mocchan0221/Denshi_fuka/README.md

# プログラマブルデジタル電子負荷
## What's this?
PCから制御、データの受信などが出来、電流値を好きな関数などで制御できる電子負荷です。

高電圧・小電流回路と低電圧・大電流回路の2つを使い分けることが出来ます。
