mocchan0221/Denshi_fuka/pcb/PDF/Final.pdf

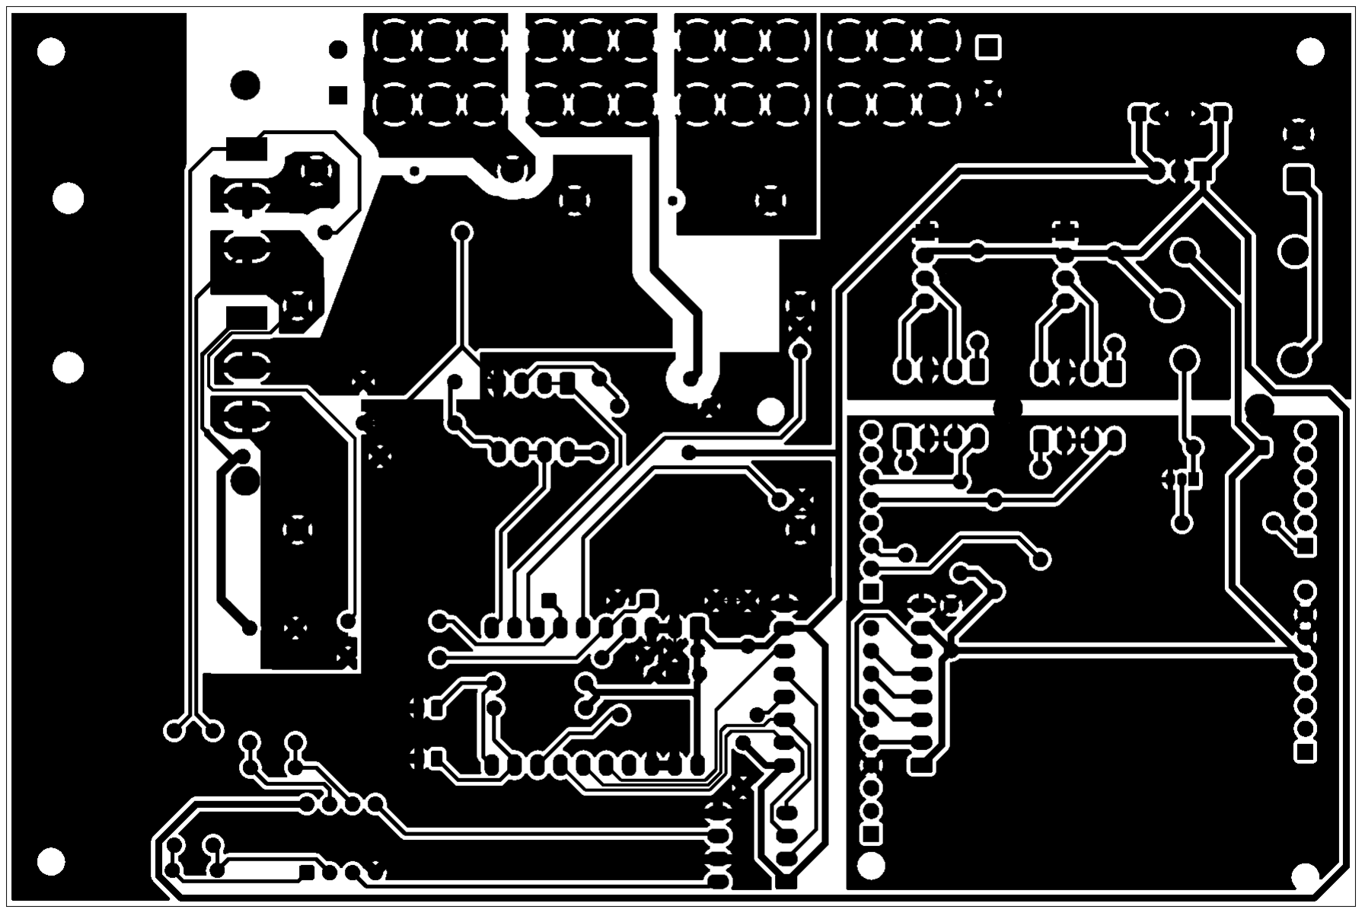
[picture p1: figure]
