mocchan0221/Denshi_fuka/pcb/PDF/アートボード 1.pdf

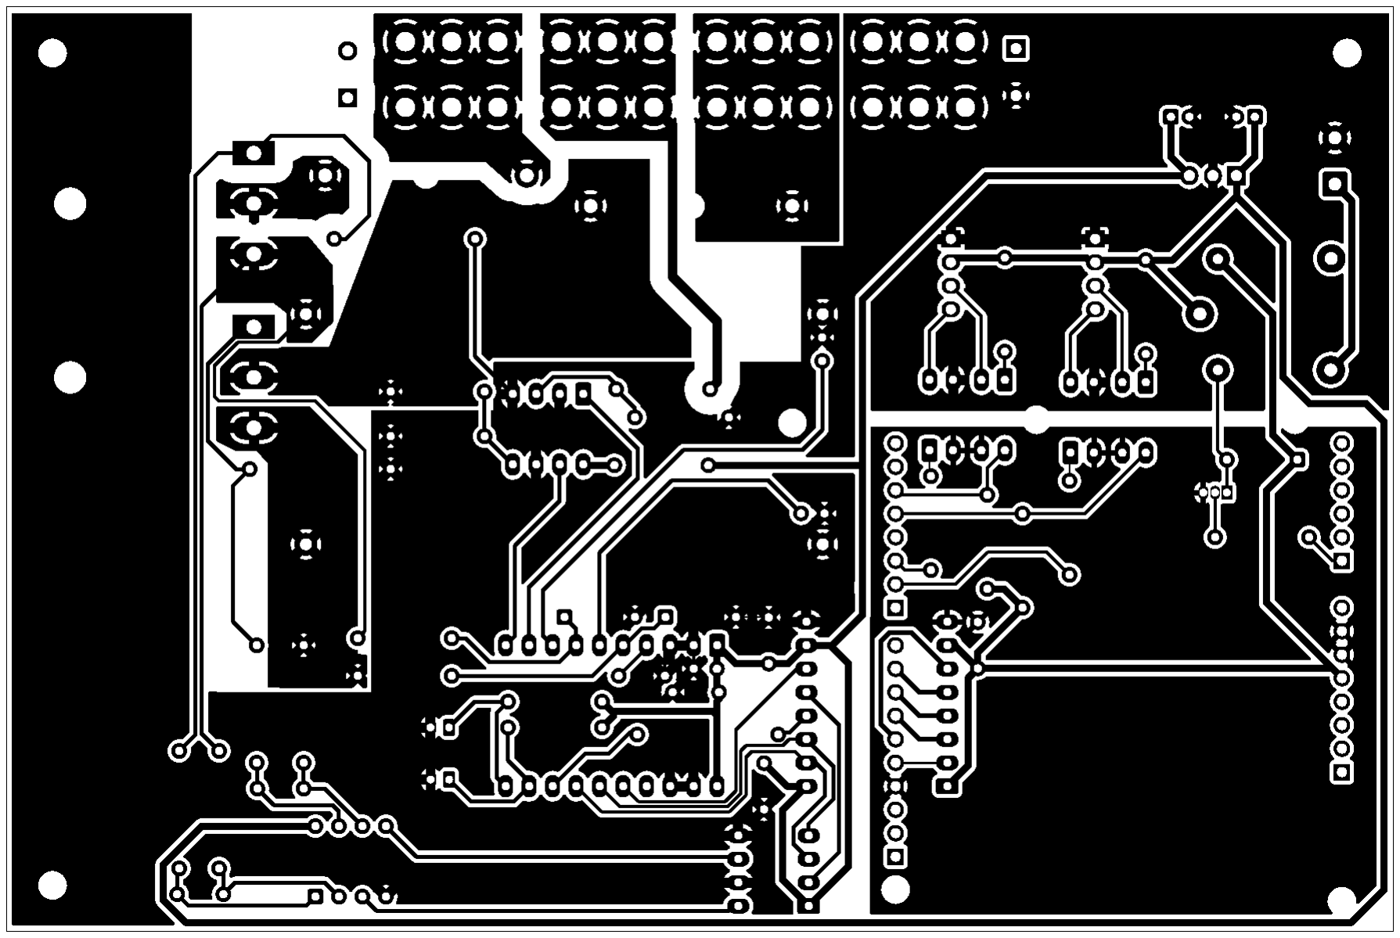
[picture p2: figure]
