mocchan0221/Denshi_fuka/pcb/PDF/エッチング.pdf

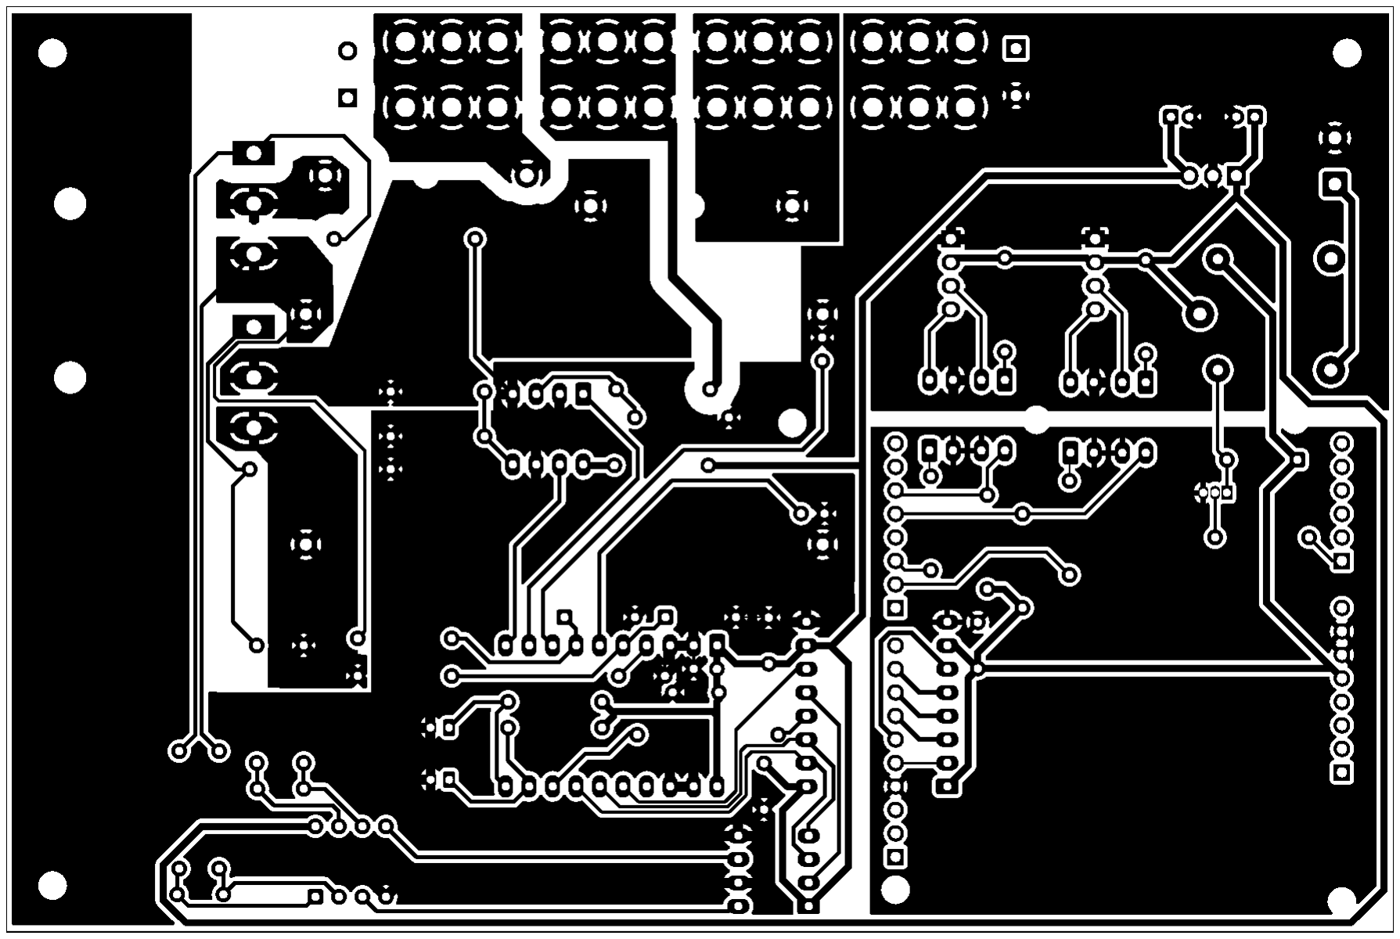
[picture p3: figure]
