mocchan0221/Denshi_fuka/case/電子負荷台座.step

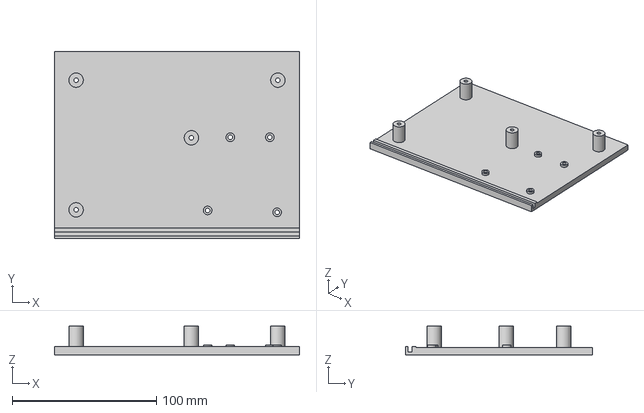
[picture p4: CAD file, 2026-05-17]
case/電子負荷台座.step
170.0 x 130.0 x 20.0 mm
