mocchan0221/Denshi_fuka/pcb/pcb.step

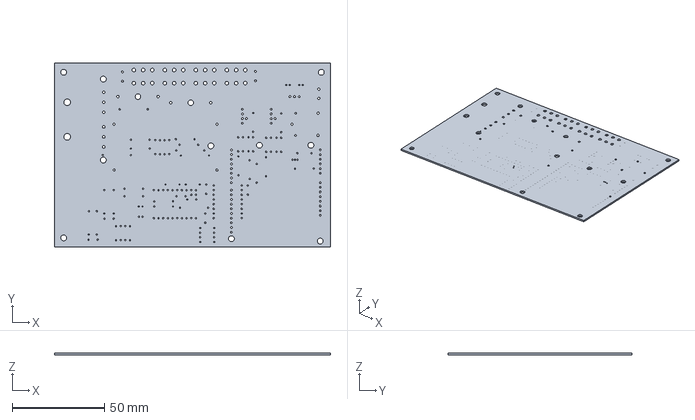
[picture p5: CAD file, 2026-05-10]
pcb/pcb.step
150.0 x 100.0 x 1.00 mm
