mocchan0221/Denshi_fuka/pcb/Denshi_fuka_sch.pdf

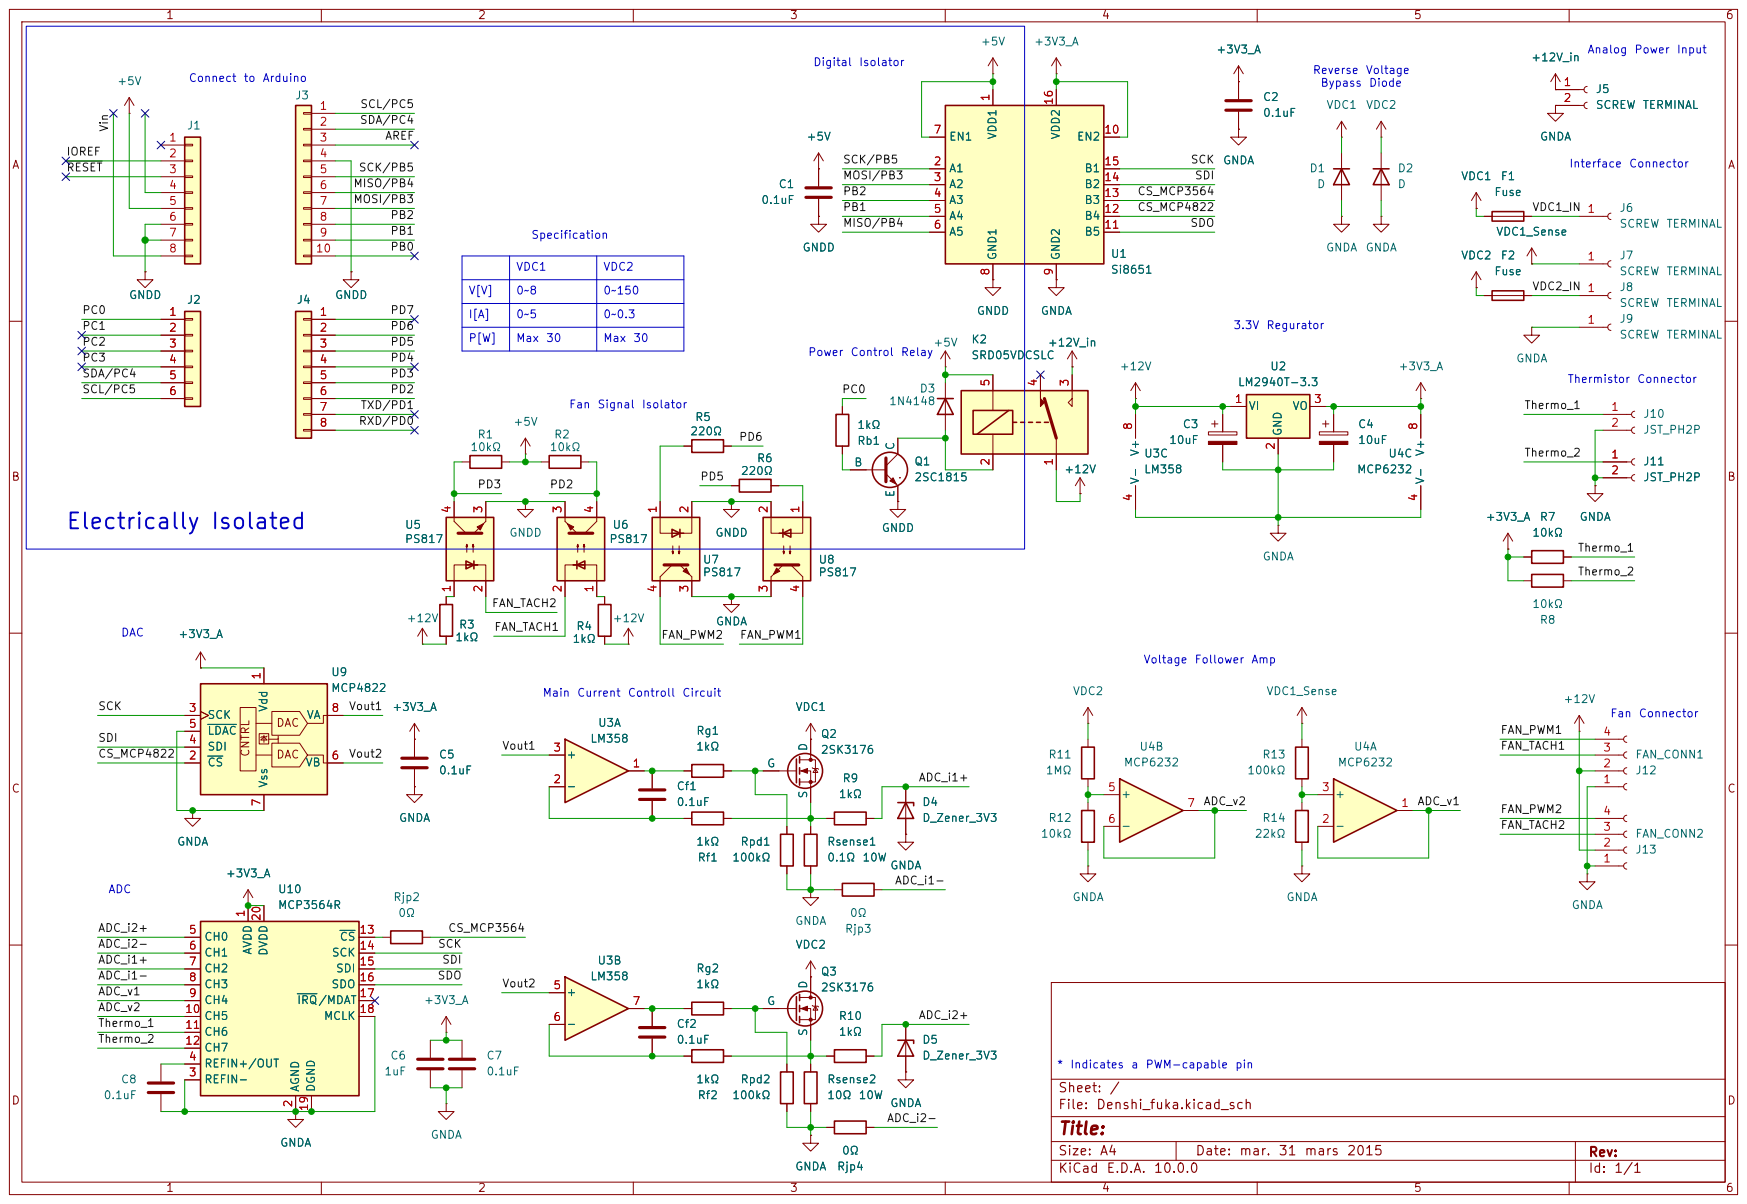
[picture p6: page 1]

Interface Connector Main Current Controll Circuit

A3 4 | CS_MCP3564
A4 5 | CS_MCP4822

Thermistor Connector Fan Connector

2 REFIN- 3 REFIN+/OUT 4 CH0 5 CH1 6 CH2 7 CH3 8 CH4 9 CH5 10 CH6 11 CH7 12 CS 13

* Indicates a PWM-capable pin
Sheet: /
D Date: mar. 31 mars 2015 KiCad E.D.A. 10.0.0
File: Denshi_fuka.kicad_sch
Title:

Size: A4 | Rev:
