mocchan0221/Denshi_fuka/pcb/Denshi_fuka_Assembly.pdf

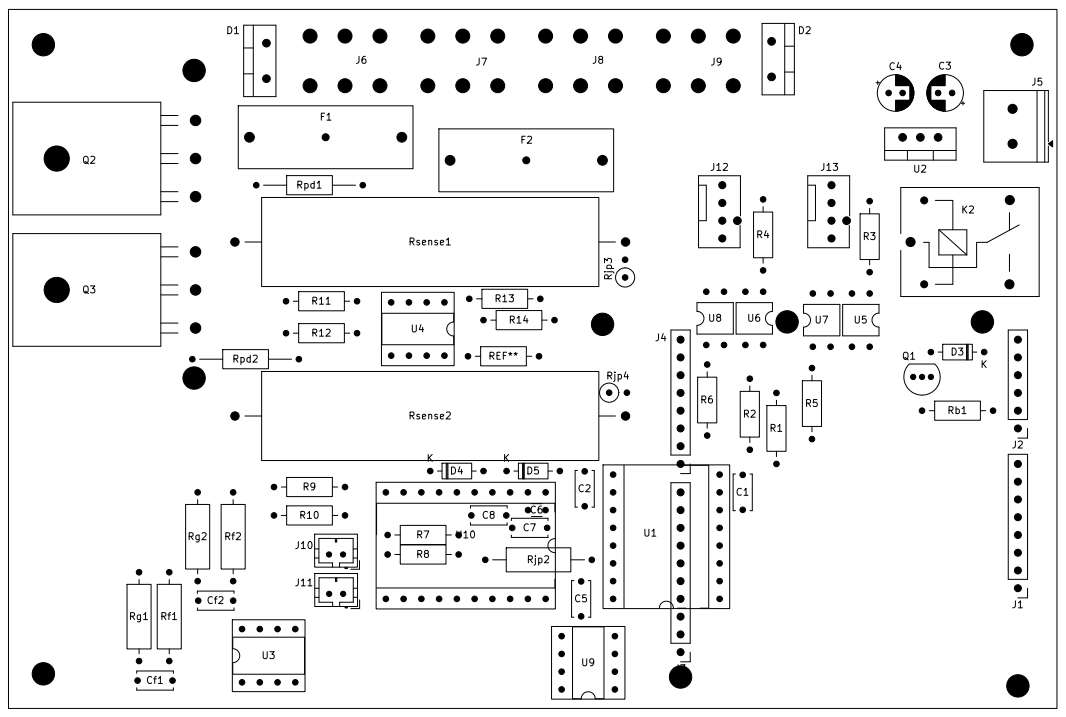
[picture p7: page 1]
