mocchan0221/Denshi_fuka/pcb/Denshi_fuka.pdf

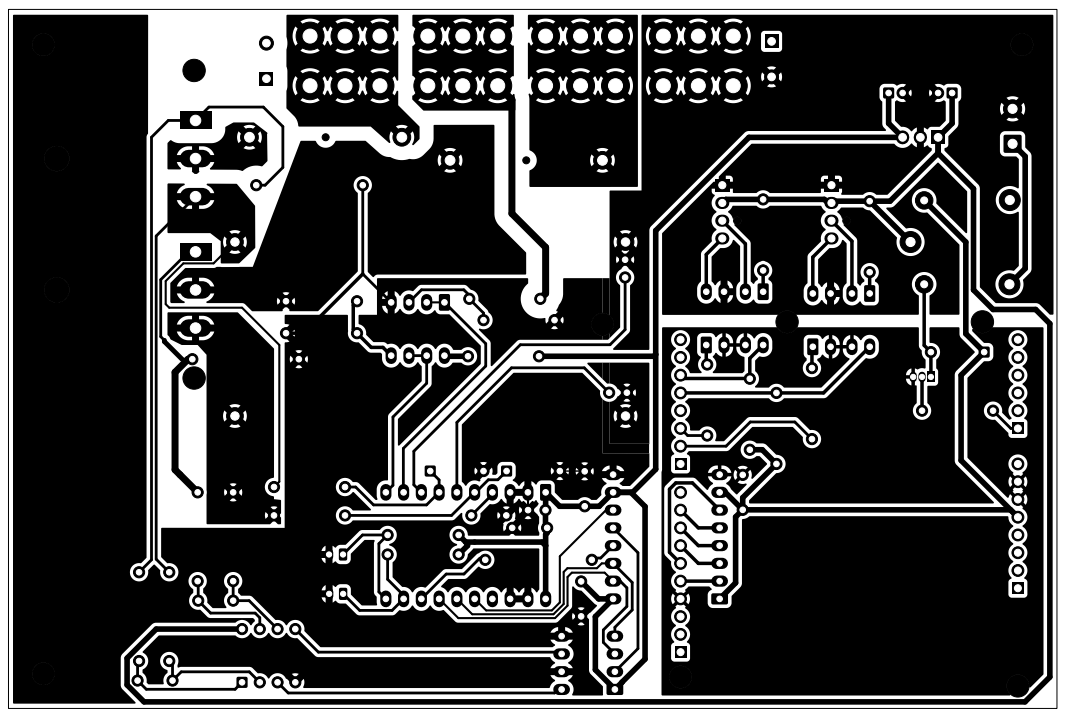
[picture p8: page 1]
