mocchan0221/Denshi_fuka/pcb/Denshi_fuka_Drill.pdf

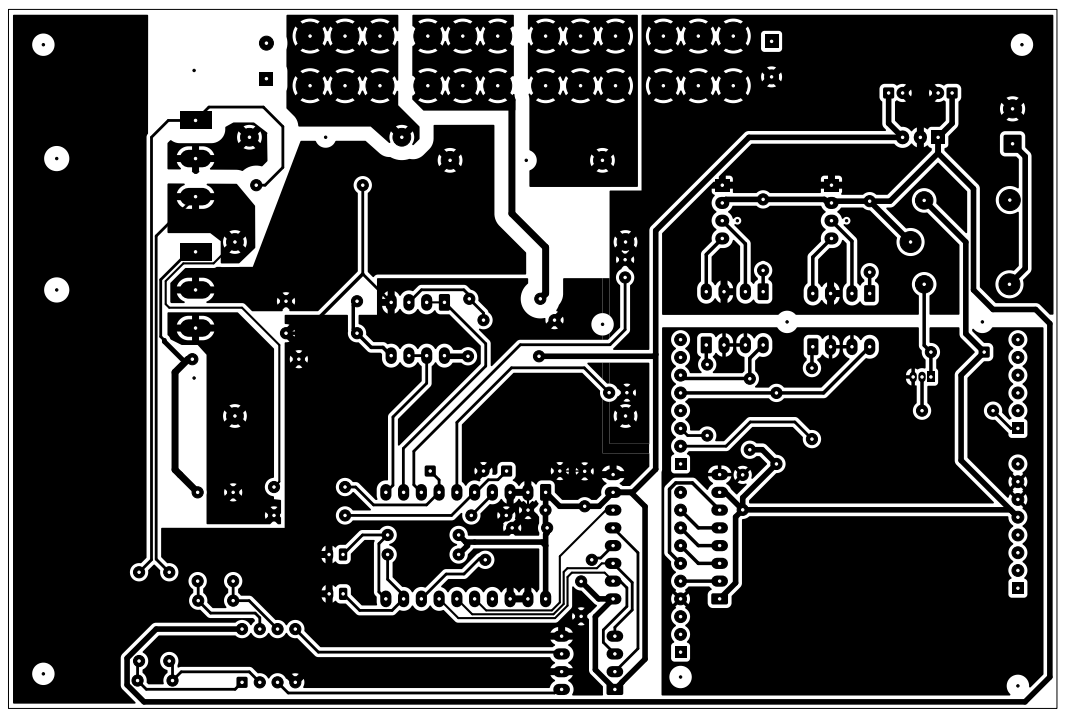
[picture p9: page 1]
