mocchan0221/Denshi_fuka/pcb/PDF/Final2.pdf

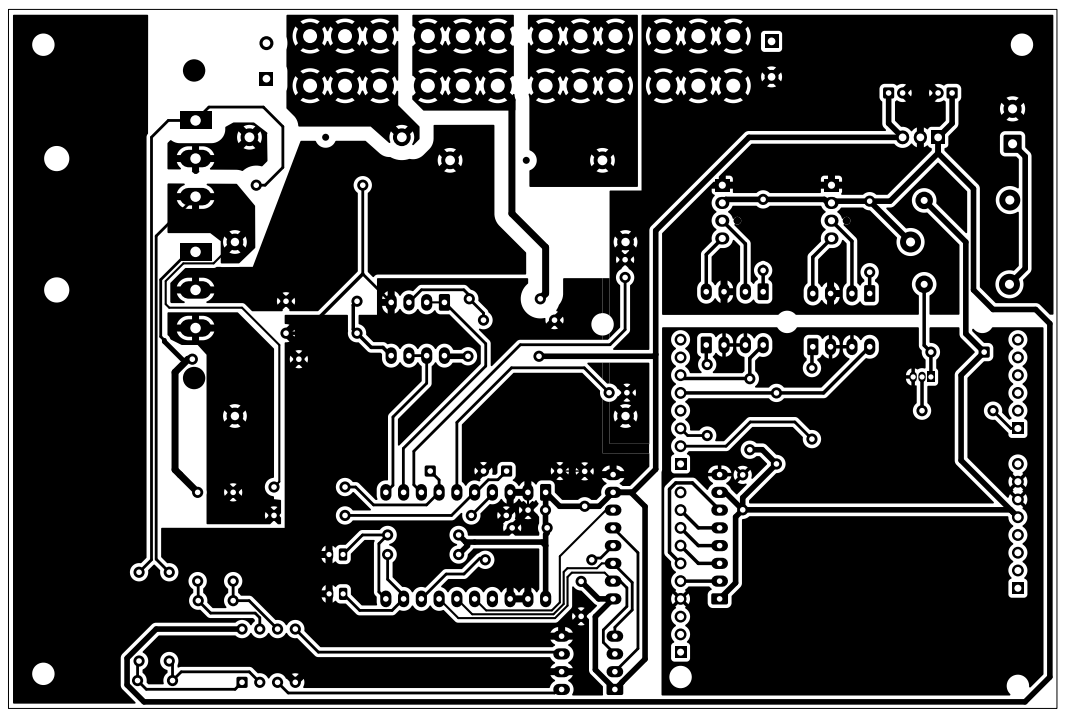
[picture p10: page 1]
