mocchan0221/Denshi_fuka/pcb/Denshi_fuka.kicad_pcb

## KiCad design pcb/Denshi_fuka.kicad_pcb (2026-05-13)

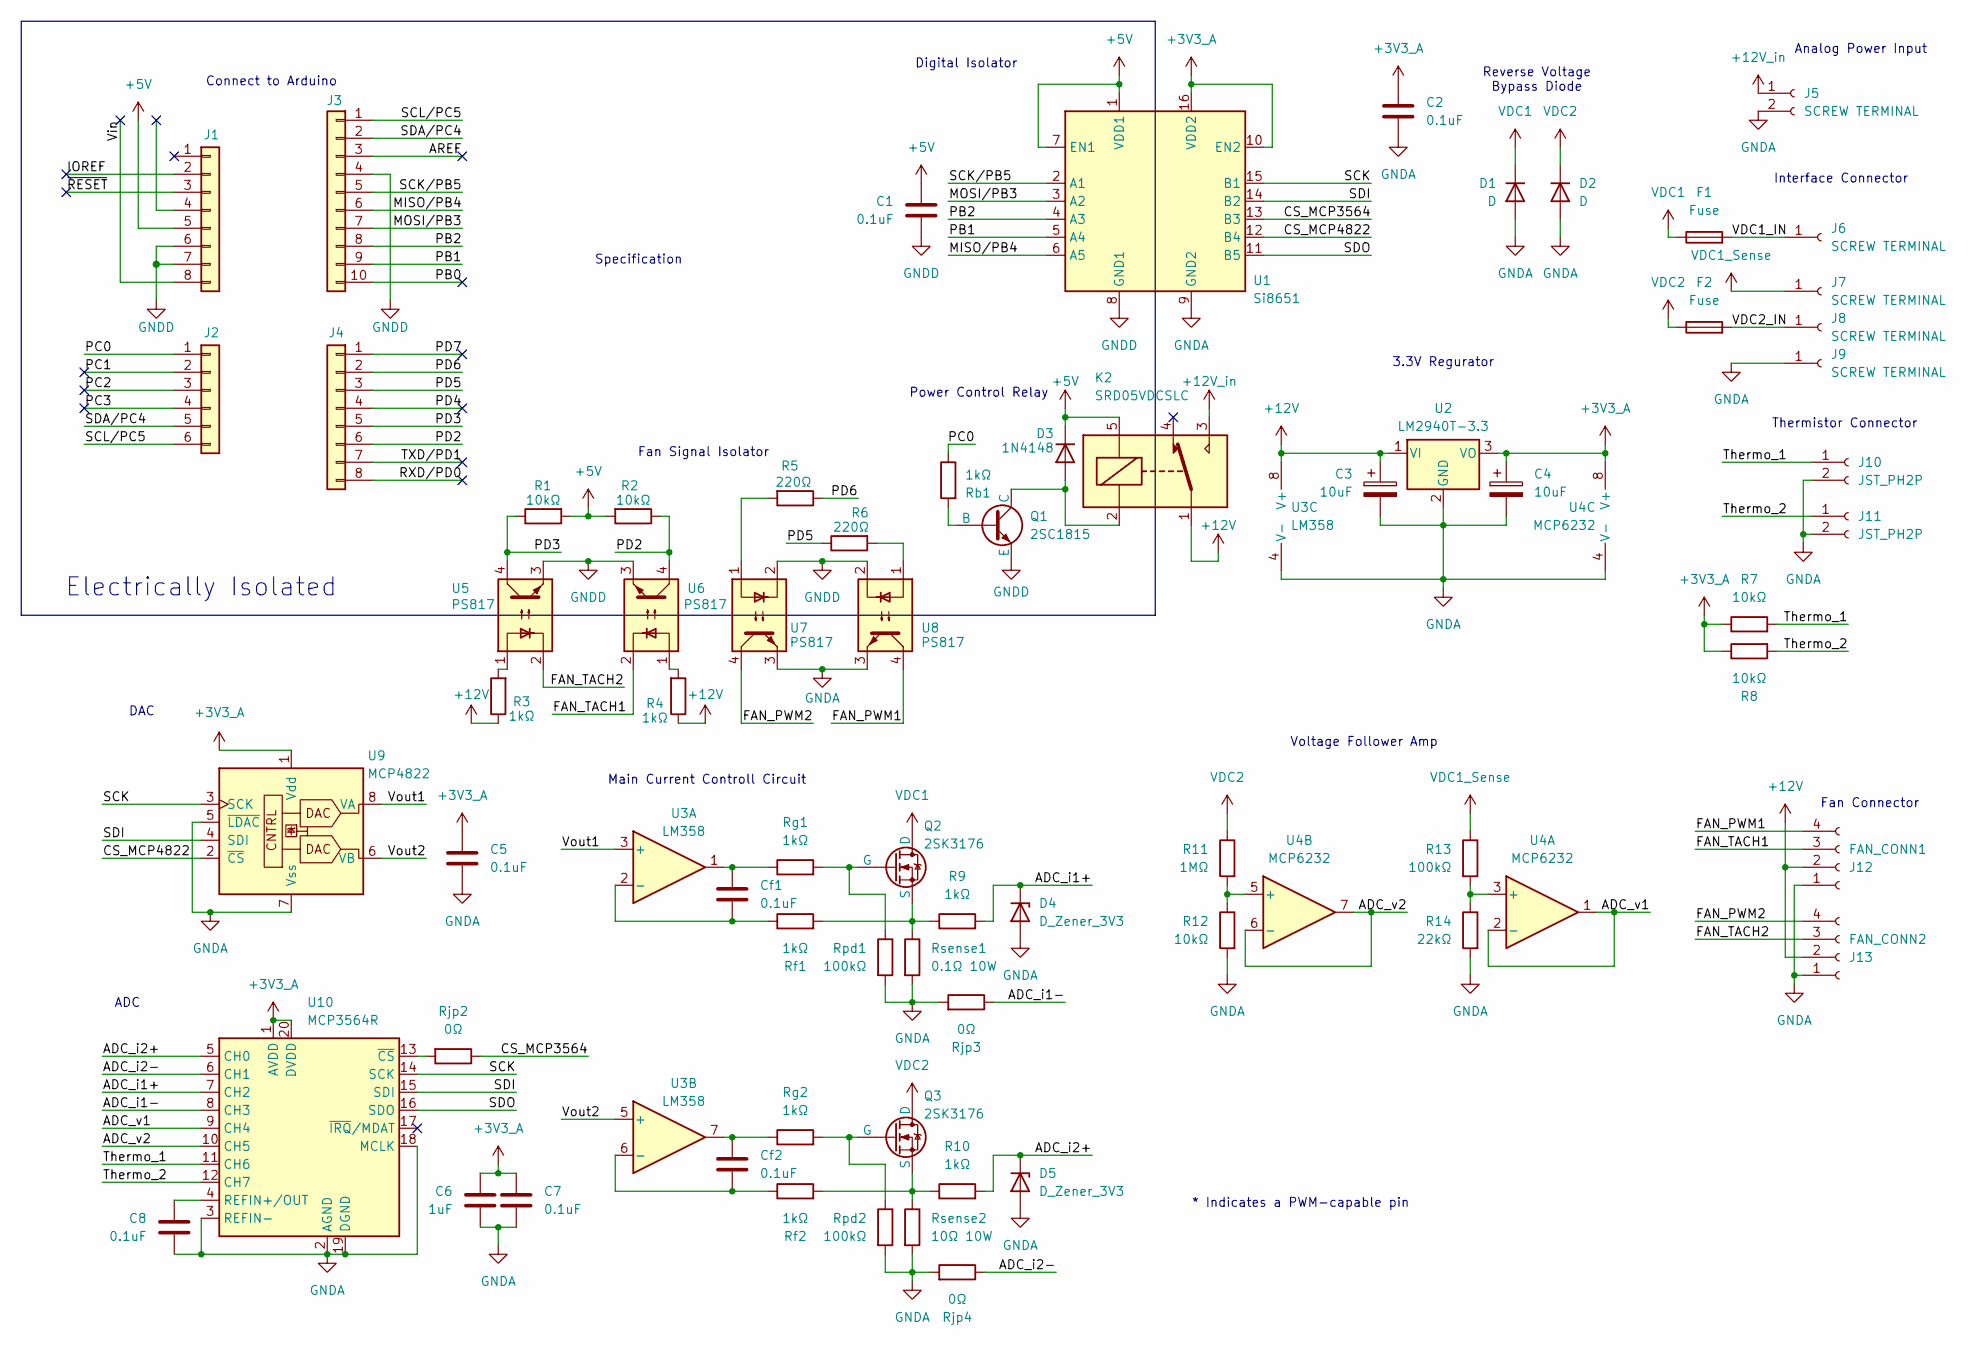
[picture p11: schematic Denshi_fuka.kicad_sch]

Parts:
C1, C2, C5, C7, C8: 0.1uF; C_Disc_D5.0mm_W2.5mm_P5.00mm
C3, C4: 10uF; CP_Radial_D5.0mm_P2.00mm
C6: 1uF; C_Disc_D3.0mm_W1.6mm_P2.50mm
Cf1, Cf2: 0.1uF; C_Disc_D5.0mm_W2.5mm_P5.00mm
D1, D2: D; TO-220-2_Vertical
D3: 1N4148; D_DO-35_SOD27_P7.62mm_Horizontal
D4, D5: D_Zener_3V3; D_DO-35_SOD27_P7.62mm_Horizontal
F1, F2: Fuse; MF-563
J1, J4: Conn_01x08; PinHeader_1x08_P2.54mm_Vertical
J2: Conn_01x06; PinHeader_1x06_P2.54mm_Vertical
J3: Conn_01x10; PinHeader_1x10_P2.54mm_Vertical
J5: SCREW TERMINAL; TerminalBlock_Phoenix_PT-1,5-2-5.0-H_1x02_P5.00mm_Horizontal
J6, J7, J8, J9: SCREW TERMINAL; PCB-20
J10, J11: JST_PH2P; JST_PH_B2B-PH-K_1x02_P2.00mm_Vertical
J12: FAN_CONN1; FanPinHeader_1x04_P2.54mm_Vertical
J13: FAN_CONN2; FanPinHeader_1x04_P2.54mm_Vertical
K2: SRD05VDCSLC; Relay_SPDT_SANYOU_SRD_Series_Form_C
Q1: 2SC1815; TO-92_Inline
Q2, Q3: 2SK3176; TO-247-3_Horizontal_TabUp
R1, R2, R7, R8, R12: 10kΩ; R_Axial_DIN0207_L6.3mm_D2.5mm_P10.16mm_Horizontal
R3, R4, R9, R10: 1kΩ; R_Axial_DIN0207_L6.3mm_D2.5mm_P10.16mm_Horizontal
R5, R6: 220Ω; R_Axial_DIN0207_L6.3mm_D2.5mm_P10.16mm_Horizontal
R11: 1MΩ; R_Axial_DIN0207_L6.3mm_D2.5mm_P10.16mm_Horizontal
R13: 100kΩ; R_Axial_DIN0207_L6.3mm_D2.5mm_P10.16mm_Horizontal
R14: 22kΩ; R_Axial_DIN0207_L6.3mm_D2.5mm_P10.16mm_Horizontal
Rb1: 1kΩ; R_Axial_DIN0207_L6.3mm_D2.5mm_P10.16mm_Horizontal
Rf1, Rf2: 1kΩ; R_Axial_DIN0309_L9.0mm_D3.2mm_P12.70mm_Horizontal
Rg1, Rg2: 1kΩ; R_Axial_DIN0309_L9.0mm_D3.2mm_P12.70mm_Horizontal
Rjp2: 0Ω; R_Axial_DIN0309_L9.0mm_D3.2mm_P15.24mm_Horizontal
Rjp3, Rjp4: 0Ω; R_Axial_DIN0207_L6.3mm_D2.5mm_P2.54mm_Vertical
Rpd1, Rpd2: 100kΩ; R_Axial_DIN0207_L6.3mm_D2.5mm_P15.24mm_Horizontal
Rsense1: 0.1Ω 10W; R_Axial_Power_L48.0mm_W12.5mm_P55.88mm
Rsense2: 10Ω 10W; R_Axial_Power_L48.0mm_W12.5mm_P55.88mm
U1: Si8651; DIP-16_W15.24mm (600mil)
U2: LM2940T-3.3; TO-220-3_Vertical
U3: LM358; DIP-8_W7.62mm_Socket
U4: MCP6232; DIP-8_W7.62mm_Socket_LongPads
U5, U6, U7, U8: PS817; DIP-4_W7.62mm_LongPads
U9: MCP4822; DIP-8_W7.62mm_Socket_LongPads
U10: MCP3564R; DIP-20_W15.24mm_Socket_LongPads

Connections:
+3V3_A: C2.1, C4.1, C5.1, C6.1, C7.1, R7.1, R8.1, U1.10 (EN2), U1.16 (VDD2), U2.3 (VO), U4.8 (V+), U9.1 (Vdd), U10.1 (AVDD), U10.20 (DVDD)
+5V: C1.1, D3.1 (K), J1.5, K2.5, R1.2, R2.2, U1.1 (VDD1), U1.7 (EN1)
+12V: C3.1, J12.2, J13.2, K2.1, R3.1, R4.1, U2.1 (VI), U3.8 (V+)
+12V_in: J5.1, K2.3
/ADC_i1+: D4.1 (K), R9.2, U10.7 (CH2)
/ADC_i1-: Rjp3.1, U10.8 (CH3)
/ADC_i2+: D5.1 (K), R10.2, U10.5 (CH0)
/ADC_i2-: Rjp4.1, U10.6 (CH1)
/ADC_v1: U4.1, U4.2 (-), U10.9 (CH4)
/ADC_v2: U4.6 (-), U4.7, U10.10 (CH5)
/AREF: J3.3
/CS_MCP3564: Rjp2.1, U1.13 (B3)
/CS_MCP4822: U1.12 (B4), U9.2 (~CS)
/FAN_PWM1: J12.4, U8.4
/FAN_PWM2: J13.4, U7.4
/FAN_TACH1: J12.3, U6.2
/FAN_TACH2: J13.3, U5.2
/IOREF: J1.2
/MISO/PB4: J3.6, U1.6 (A5)
/MOSI/PB3: J3.7, U1.3 (A2)
/PB0: J3.10
/PB1: J3.9, U1.5 (A4)
/PB2: J3.8, U1.4 (A3)
/PC0: J2.1, Rb1.1
/PC1: J2.2
/PC2: J2.3
/PC3: J2.4
/PD2: J4.6, R2.1, U6.4
/PD3: J4.5, R1.1, U5.4
/PD4: J4.4
/PD5: J4.3, R6.1
/PD6: J4.2, R5.1
/PD7: J4.1
/RXD/PD0: J4.8
/SCK: U1.15 (B1), U9.3 (SCK), U10.14 (SCK)
/SCK/PB5: J3.5, U1.2 (A1)
/SCL/PC5: J2.6, J3.1
/SDA/PC4: J2.5, J3.2
/SDI: U1.14 (B2), U9.4 (SDI), U10.15 (SDI)
/SDO: U1.11 (B5), U10.16 (SDO)
/TXD/PD1: J4.7
/Thermo_1: J10.1, R7.2, U10.11 (CH6)
/Thermo_2: J11.1, R8.2, U10.12 (CH7)
/VDC1_IN: F1.2, J6.1 (Pin_1_1)
/VDC2_IN: F2.2, J8.1 (Pin_1_1)
/Vin: J1.8
/Vout1: U3.3 (+), U9.8 (VA)
/Vout2: U3.5 (+), U9.6 (VB)
/~RESET: J1.3
GNDA: C2.2, C3.2, C4.2, C5.2, C6.2, C7.2, C8.2, D1.2 (A), D2.2 (A), D4.2 (A), D5.2 (A), J5.2, J9.1 (Pin_1_1), J10.2, J11.2, J12.1, J13.1, R12.2, R14.2, Rjp3.2, Rjp4.2, Rpd1.2, Rpd2.2, Rsense1.2, Rsense2.2, U1.9 (GND2), U2.2 (GND), U3.4 (V-), U4.4 (V-), U7.3, U8.3, U9.5 (~LDAC), U9.7 (Vss), U10.2 (AGND), U10.3 (REFIN-), U10.18 (MCLK), U10.19 (DGND)
GNDD: C1.2, J1.6, J1.7, J3.4, Q1.3 (E), U1.8 (GND1), U5.3, U6.3, U7.2, U8.2
unnamed: Cf1.1, Rg1.1, U3.1
unnamed: Cf2.1, Rg2.1, U3.7
unnamed: D3.2 (A), K2.2, Q1.1 (C)
unnamed: Q1.2 (B), Rb1.2
unnamed: Q2.1 (G), Rg1.2, Rpd1.1
unnamed: Q2.3 (S), R9.1, Rf1.2, Rsense1.1
unnamed: Q3.1 (G), Rg2.2, Rpd2.1
unnamed: Q3.3 (S), R10.1, Rf2.2, Rsense2.1
unnamed: R3.2, U5.1
unnamed: R4.2, U6.1
unnamed: R5.2, U7.1
unnamed: R6.2, U8.1
unnamed: Cf1.2, Rf1.1, U3.2 (-)
unnamed: Cf2.2, Rf2.1, U3.6 (-)
unnamed: R13.2, R14.1, U4.3 (+)
unnamed: R11.2, R12.1, U4.5 (+)
unnamed: C8.1, U10.4 (REFIN+/OUT)
unnamed: Rjp2.2, U10.13 (~CS)
VDC1: D1.1 (K), F1.1, Q2.2 (D)
VDC1_Sense: J7.1 (Pin_1_1), R13.1
VDC2: D2.1 (K), F2.1, Q3.2 (D), R11.1

Notes on the sheet:
Interface Connector
Electrically Isolated
Fan Connector
Analog Power Input
Digital Isolator
Specification
Fan Signal Isolator
Thermistor Connector
Main Current Controll Circuit
Voltage Follower Amp
Power Control Relay
* Indicates a PWM-capable pin
3.3V Regurator
Reverse Voltage Bypass Diode
Connect to Arduino
ADC
DAC

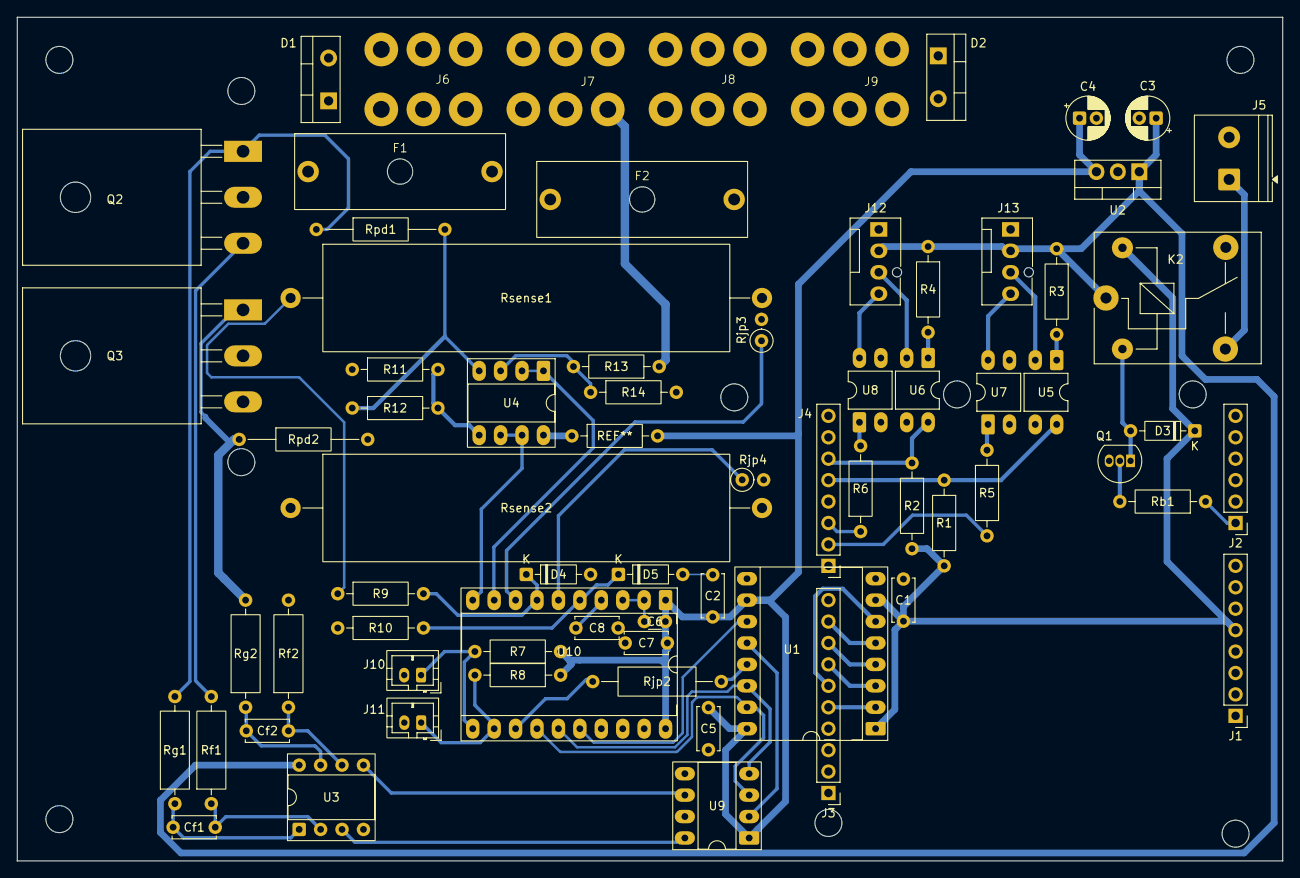
[picture p12: board Denshi_fuka.kicad_pcb from above]

Board: 2 copper layers, 150.0 x 100.0 mm, 74 parts (0 on the bottom side), 60 nets.

Other parts of the board:
MH1, MH2, MH3, MH4: MountingHole_3.2mm
