mocchan0221/Denshi_fuka/(commit log)

2026-04-24 add pio project and modify circuit
    [Denshi_fuka.kicad_pcb, Denshi_fuka.kicad_sch]
2026-04-24 add PC and BOM
    [BOM.csv]
2026-04-28 schematic completed!
    [BOM.csv, Denshi_fuka.kicad_sch]
2026-04-29 modify sch
    [Denshi_fuka.kicad_sch]
2026-04-30 little modify
    [BOM.csv]
2026-05-01 add some circuit
    [Denshi_fuka.kicad_sch]
2026-05-08 test plot
    [Denshi_fuka.kicad_pcb]
2026-05-09 test step
    [.step, Denshi_fuka.kicad_pcb]
2026-05-10 pcb kansei
    [.step, Denshi_fuka.kicad_pcb, Denshi_fuka.kicad_sch, pcb.step]
2026-05-11 pcb first done
    [Denshi_fuka.kicad_pcb, Denshi_fuka.kicad_sch]
2026-05-17 add daiza
    [daiza.step]
2026-05-17 modify daiza
    [daiza.step, 電子負荷台座.step]
